simonjohansson/sovol-sv01-upgrades/img/frame/cross_after_1.JPG

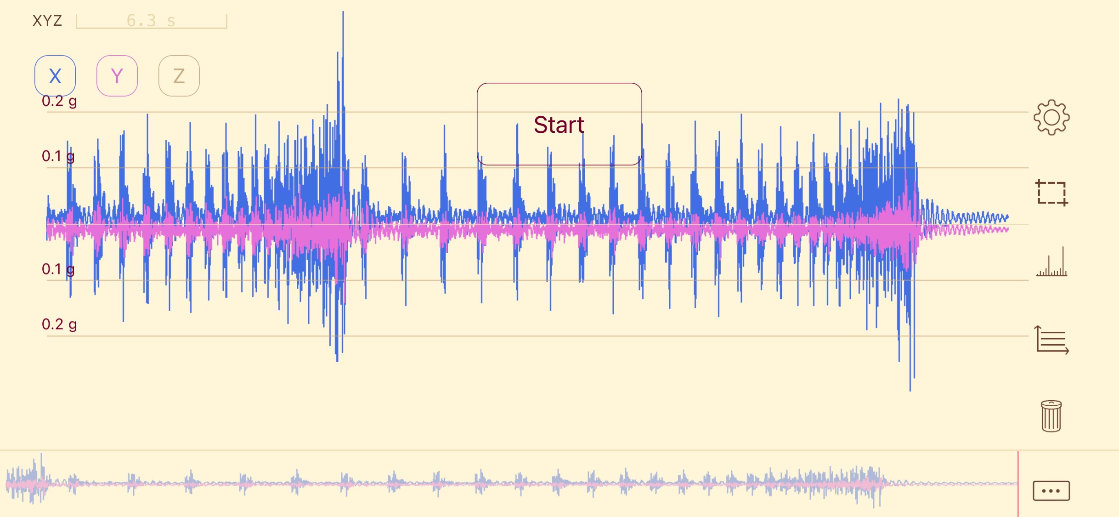
img/frame/cross_after_1.JPG
