simonjohansson/sovol-sv01-upgrades/img/frame/cross_after_2.JPG

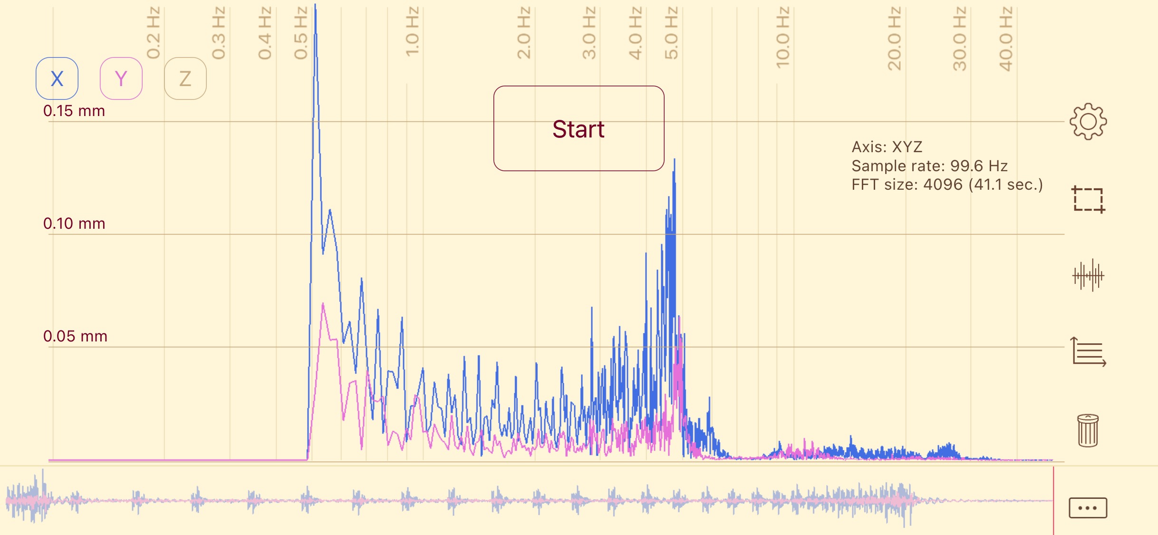
img/frame/cross_after_2.JPG
