simonjohansson/sovol-sv01-upgrades/img/frame/cross_before_1.JPG

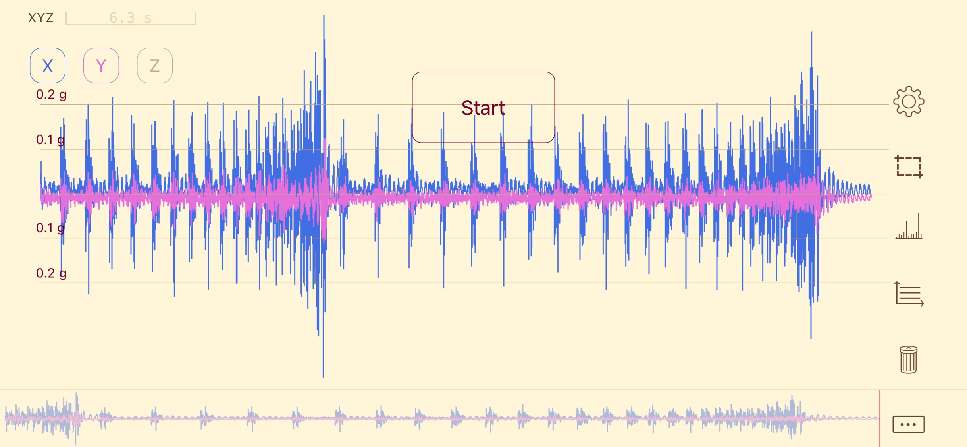
img/frame/cross_before_1.JPG
