simonjohansson/sovol-sv01-upgrades/img/frame/cross_before_2.JPG

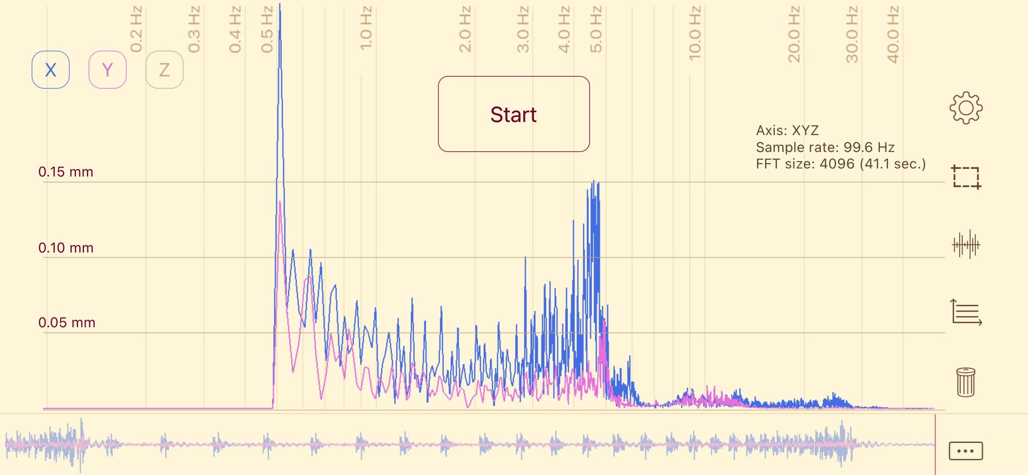
img/frame/cross_before_2.JPG
