simonjohansson/sovol-sv01-upgrades/img/frame/cross_comparison.jpg

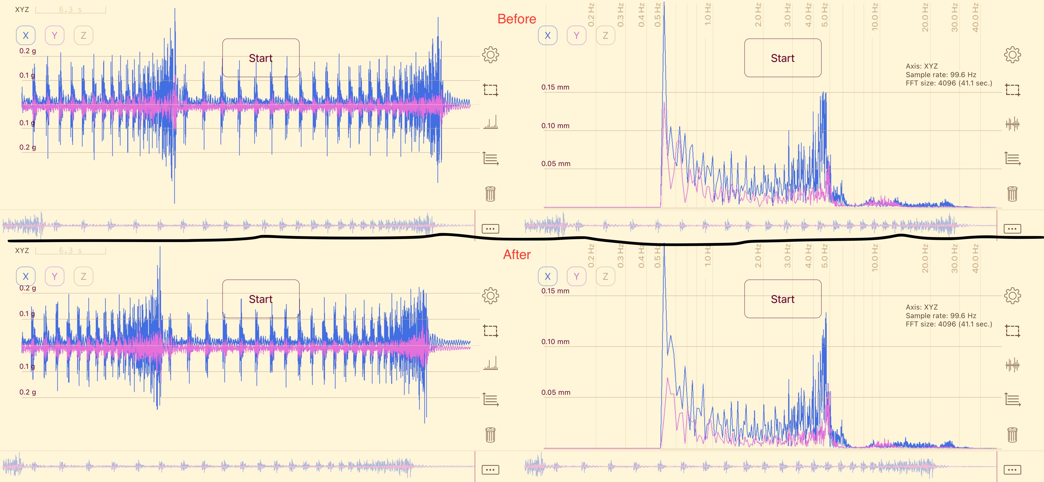
img/frame/cross_comparison.jpg
