simonjohansson/sovol-sv01-upgrades/img/frame/placement.jpg

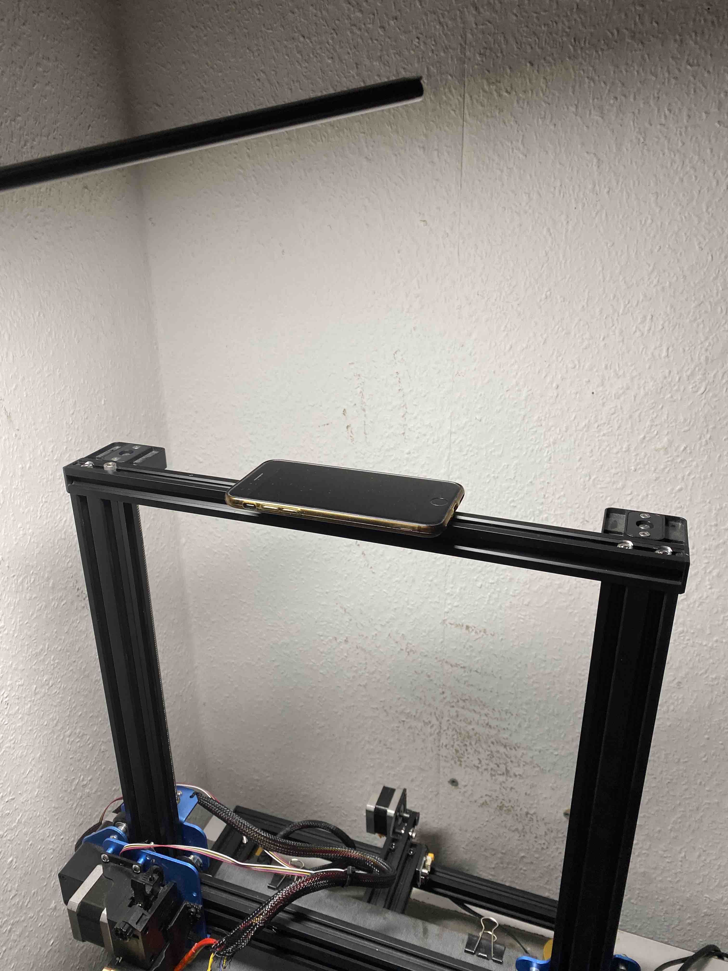
img/frame/placement.jpg
