simonjohansson/sovol-sv01-upgrades/img/frame/x_after_feet_1.JPG

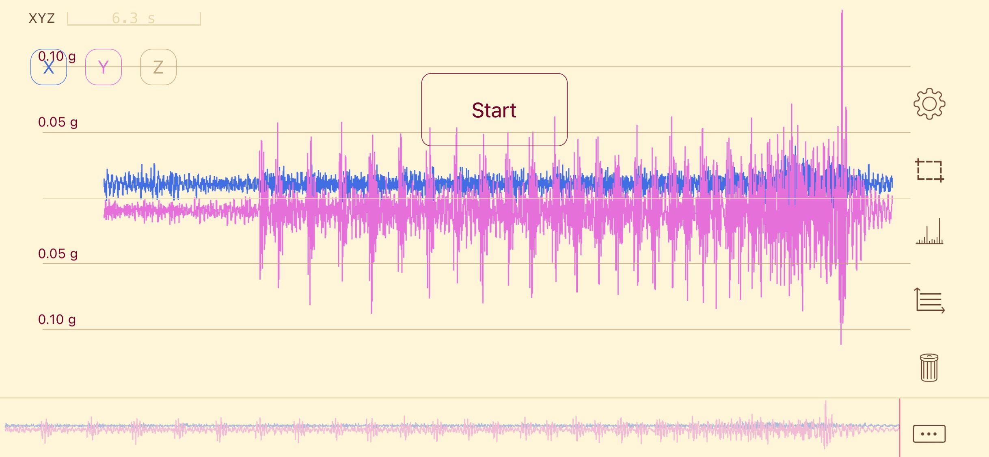
img/frame/x_after_feet_1.JPG
