simonjohansson/sovol-sv01-upgrades/img/frame/x_after_feet_2.JPG

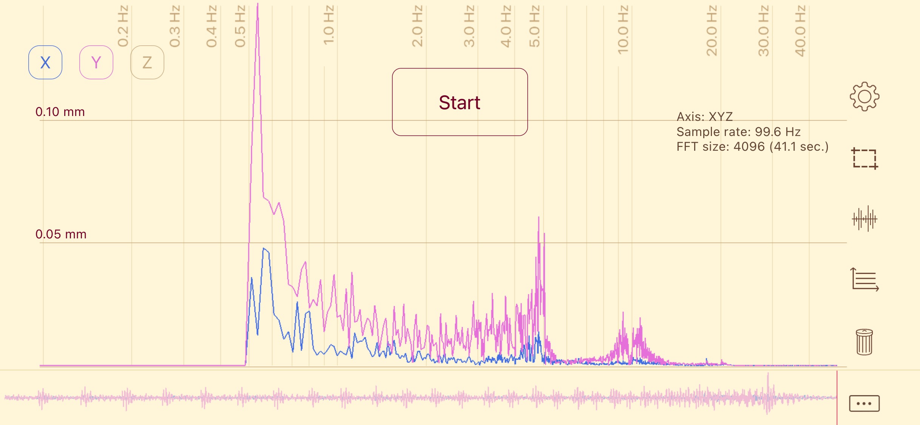
img/frame/x_after_feet_2.JPG
