simonjohansson/sovol-sv01-upgrades/img/frame/x_before_1.JPG

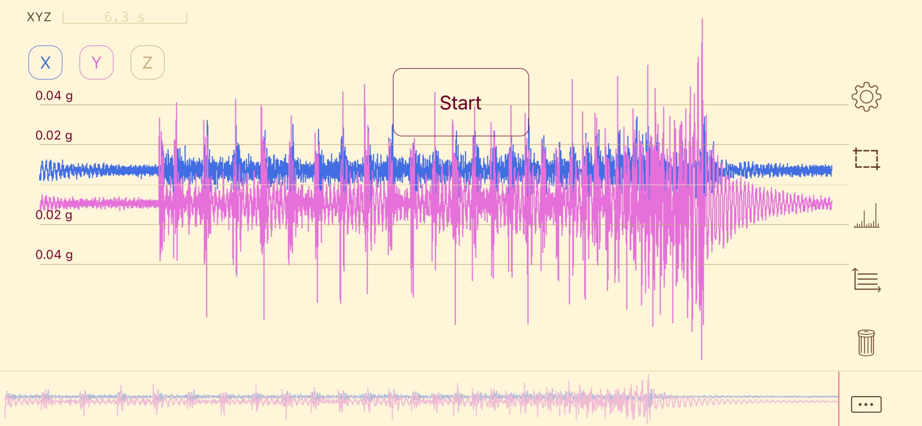
img/frame/x_before_1.JPG
