simonjohansson/sovol-sv01-upgrades/img/frame/x_before_2.JPG

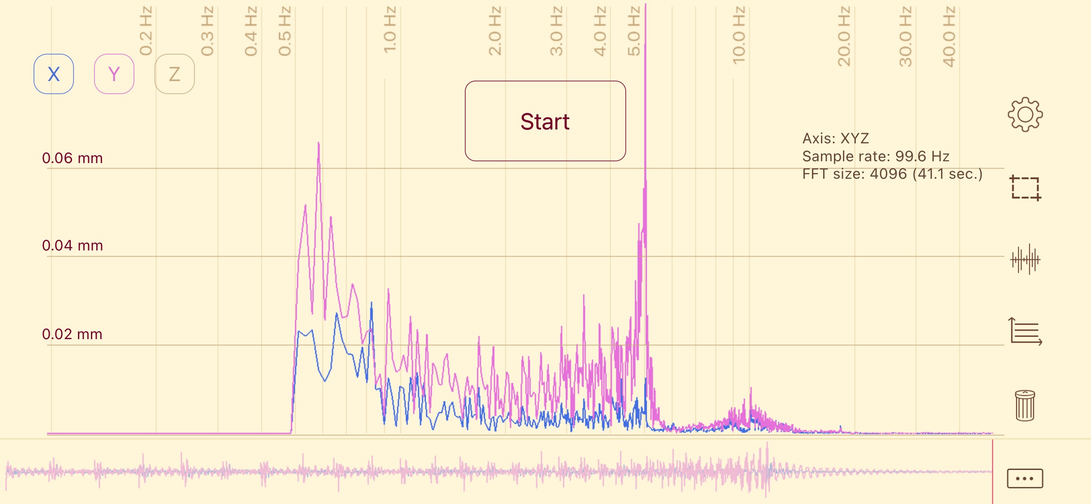
img/frame/x_before_2.JPG
