simonjohansson/sovol-sv01-upgrades/img/frame/x_comparison.jpg

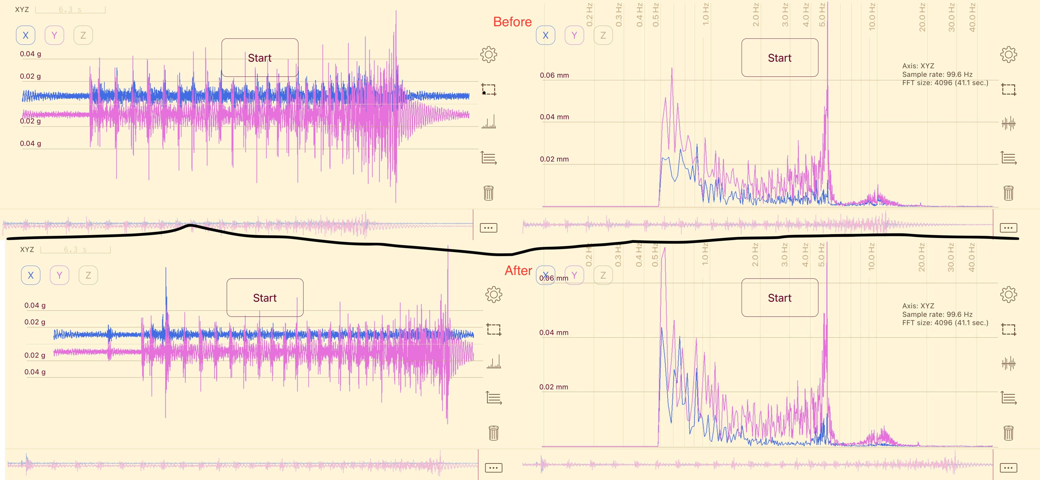
img/frame/x_comparison.jpg
