simonjohansson/sovol-sv01-upgrades/img/frame/y_after_1.JPG

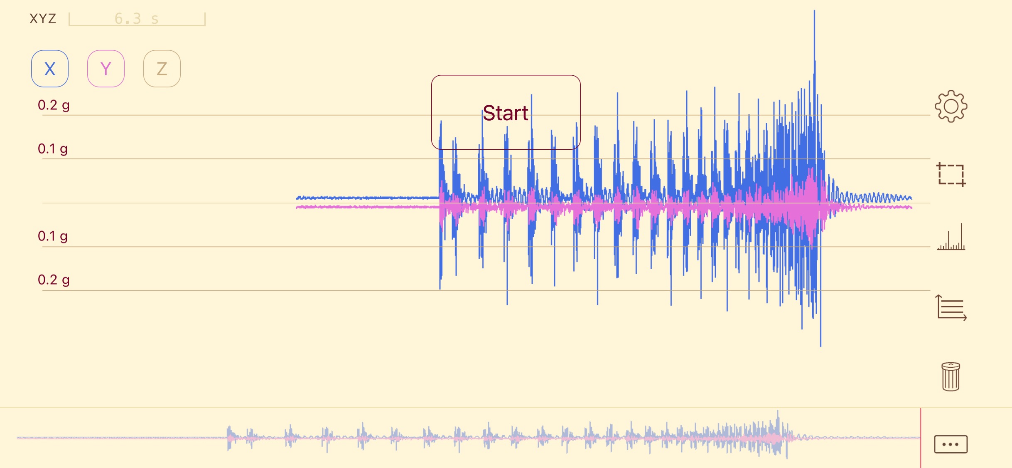
img/frame/y_after_1.JPG
