simonjohansson/sovol-sv01-upgrades/img/frame/y_after_2.JPG

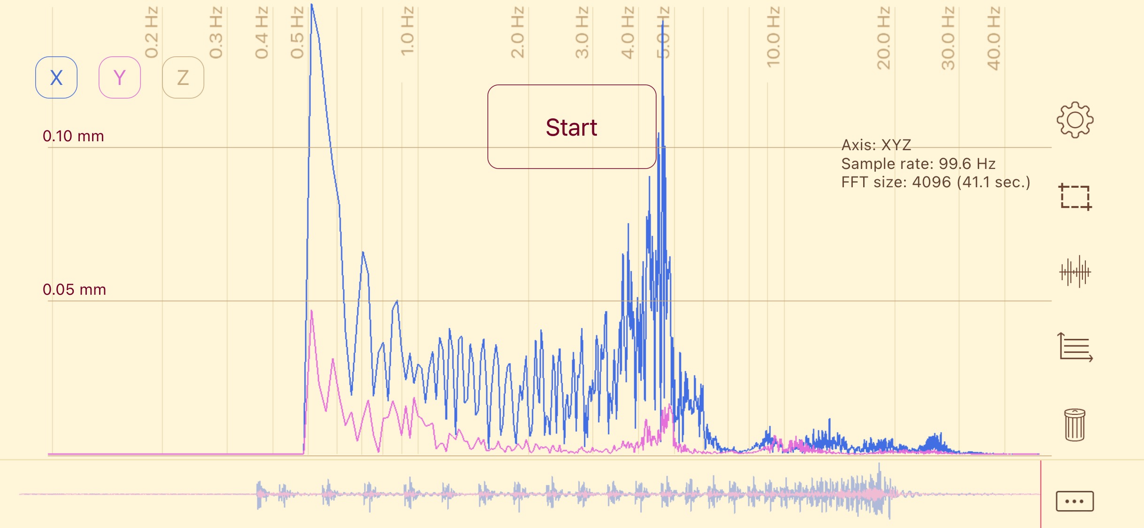
img/frame/y_after_2.JPG
