simonjohansson/sovol-sv01-upgrades/img/frame/y_after_feet_2.JPG

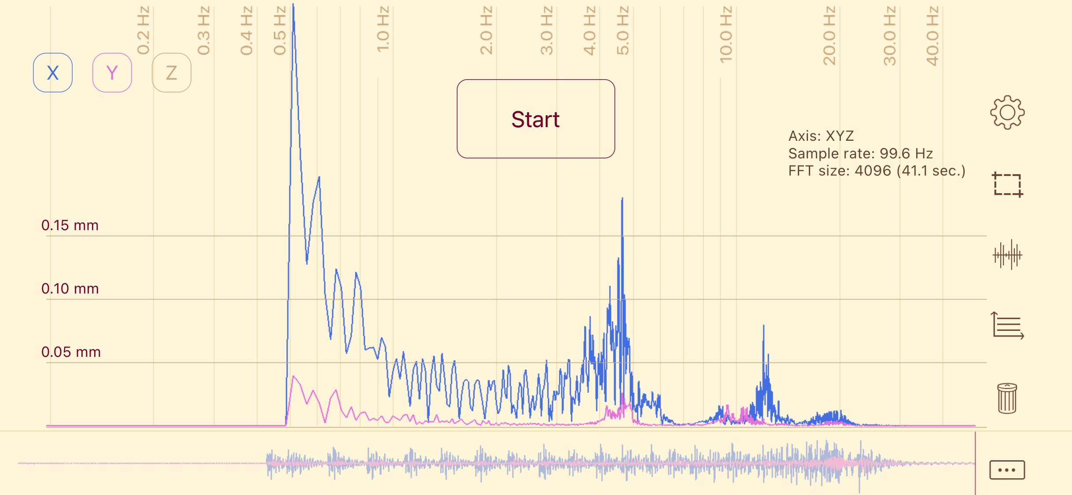
img/frame/y_after_feet_2.JPG
