simonjohansson/sovol-sv01-upgrades/img/frame/y_before_1.JPG

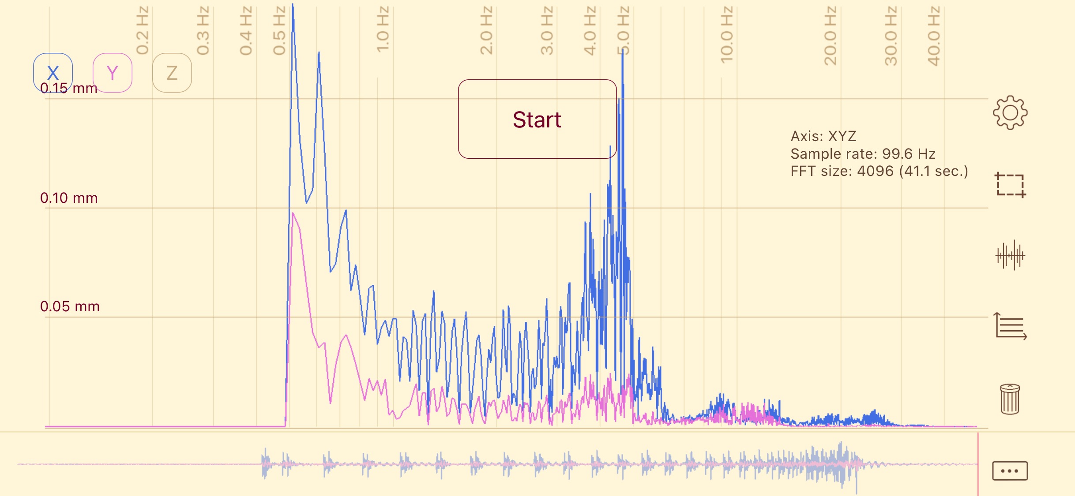
img/frame/y_before_1.JPG
