simonjohansson/sovol-sv01-upgrades/img/frame/y_before_2.JPG

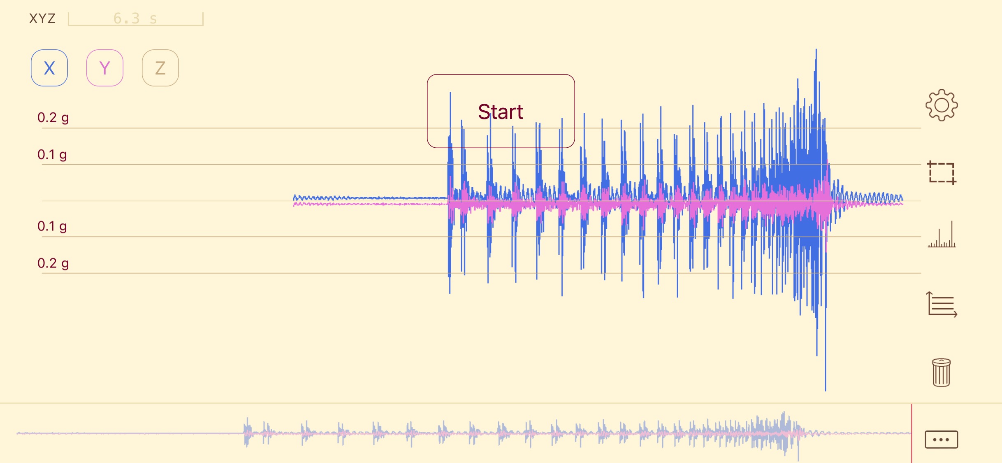
img/frame/y_before_2.JPG
