simonjohansson/sovol-sv01-upgrades/img/frame/y_comparison.jpg

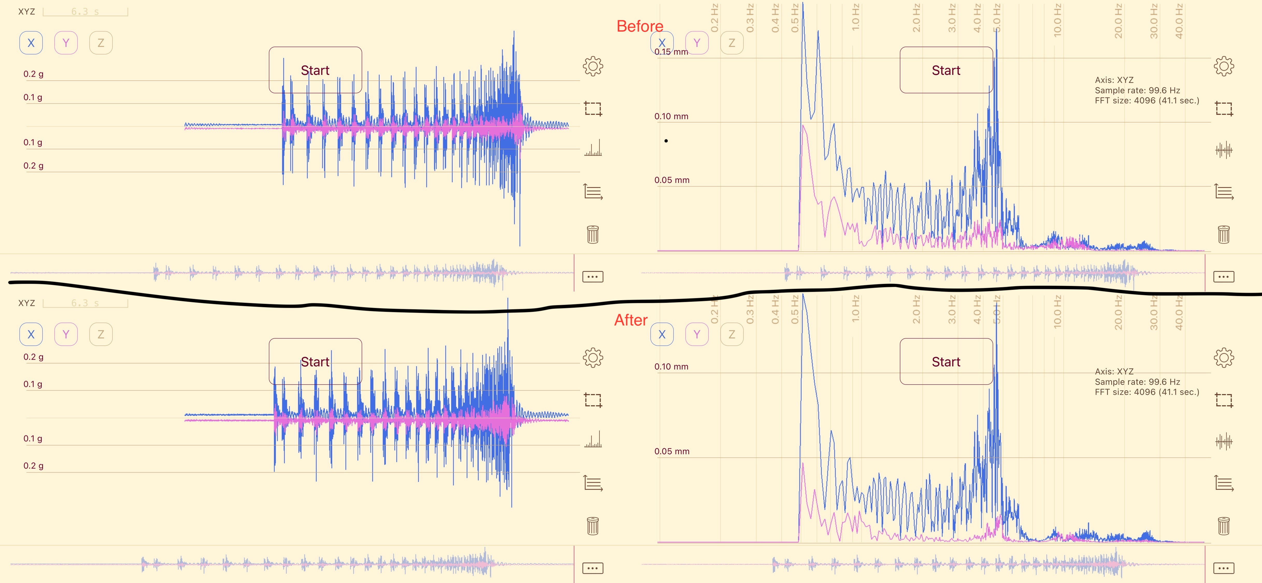
img/frame/y_comparison.jpg
