simonjohansson/sovol-sv01-upgrades/img/resonance/x_after.png

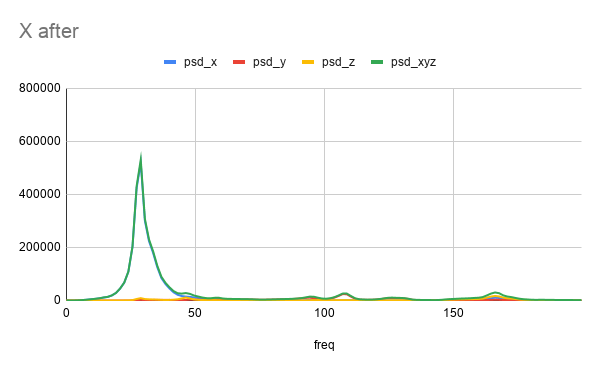
img/resonance/x_after.png
