simonjohansson/sovol-sv01-upgrades/img/resonance/x_after_log.png

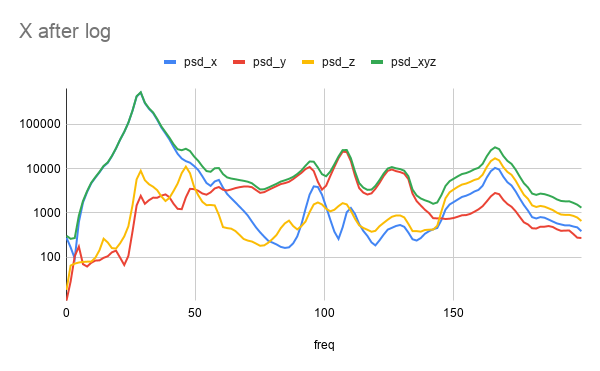
img/resonance/x_after_log.png
