simonjohansson/sovol-sv01-upgrades/img/resonance/x_before_log.png

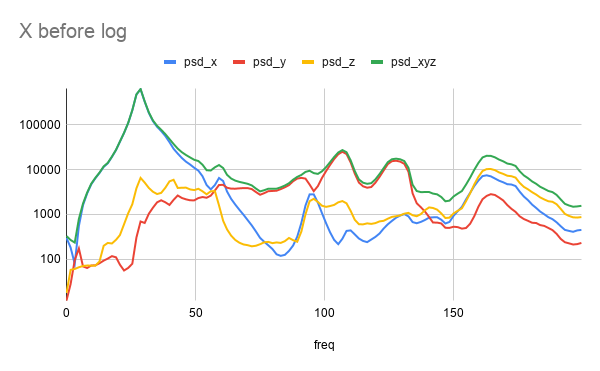
img/resonance/x_before_log.png
