simonjohansson/sovol-sv01-upgrades/img/resonance/y_after_log.png

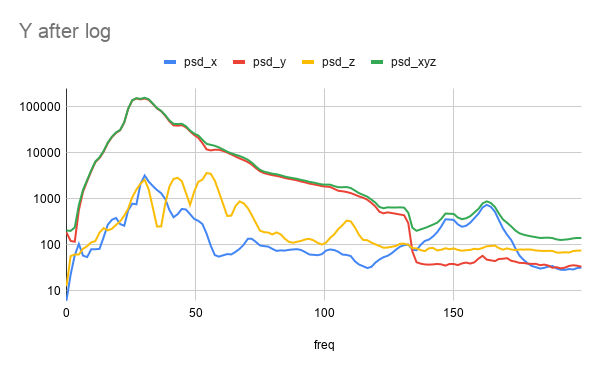
img/resonance/y_after_log.png
