simonjohansson/sovol-sv01-upgrades/img/resonance/y_before_log.png

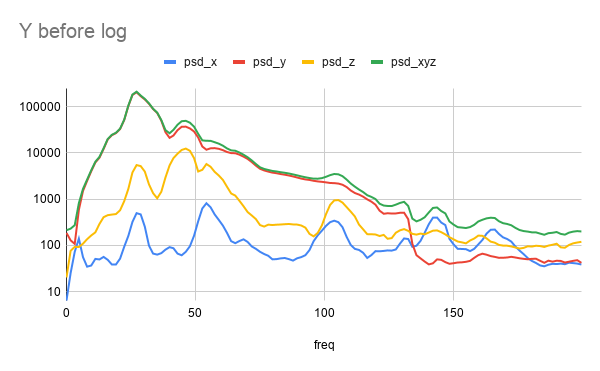
img/resonance/y_before_log.png
