simonjohansson/sovol-sv01-upgrades/img/resonance/shaper_calibrate_x_after.png

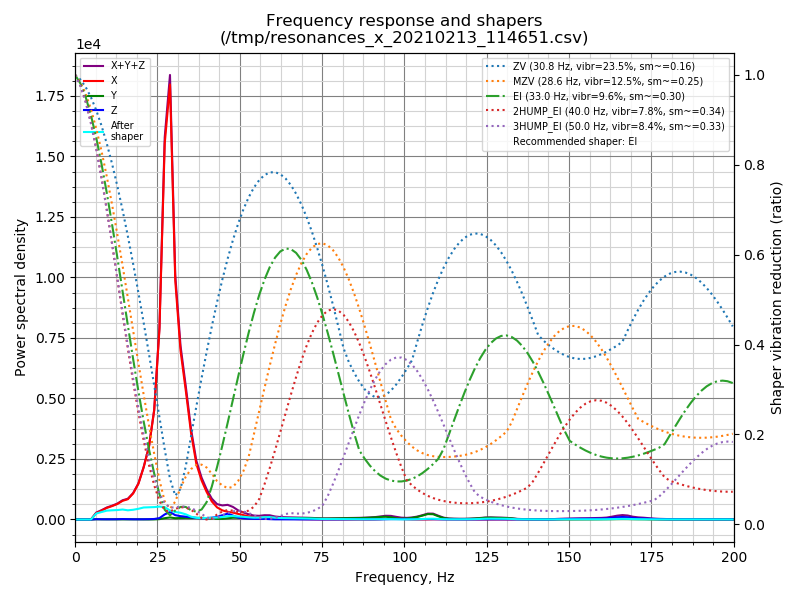
img/resonance/shaper_calibrate_x_after.png
