simonjohansson/sovol-sv01-upgrades/img/resonance/shaper_calibrate_x_before.png

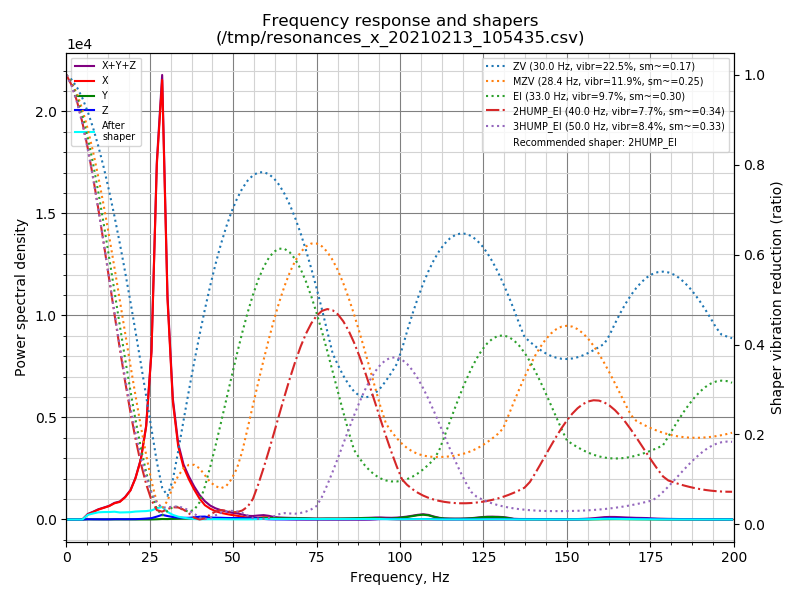
img/resonance/shaper_calibrate_x_before.png
