simonjohansson/sovol-sv01-upgrades/img/resonance/shaper_calibrate_y_after.png

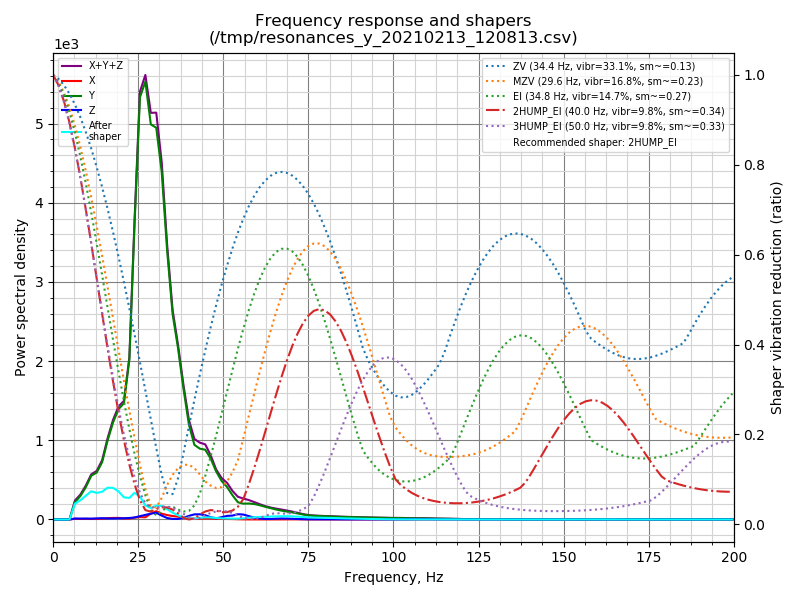
img/resonance/shaper_calibrate_y_after.png
