simonjohansson/sovol-sv01-upgrades/(commit log)

2021-01-25 Add klipper configs
    [skr-mini-e3-v2-printer.cfg, stock-or-silent-creality-bltouch.cfg]
2021-02-13 Add some new images
    [resonances_x_after.csv, resonances_x_before.csv, resonances_y_after.csv, resonances_y_before.csv]
2021-02-13 Move some files around
    [resonances_x_after.csv, resonances_x_before.csv, resonances_y_after.csv, resonances_y_before.csv]
